himwho/jf-pimpleclock/image/ARM.png

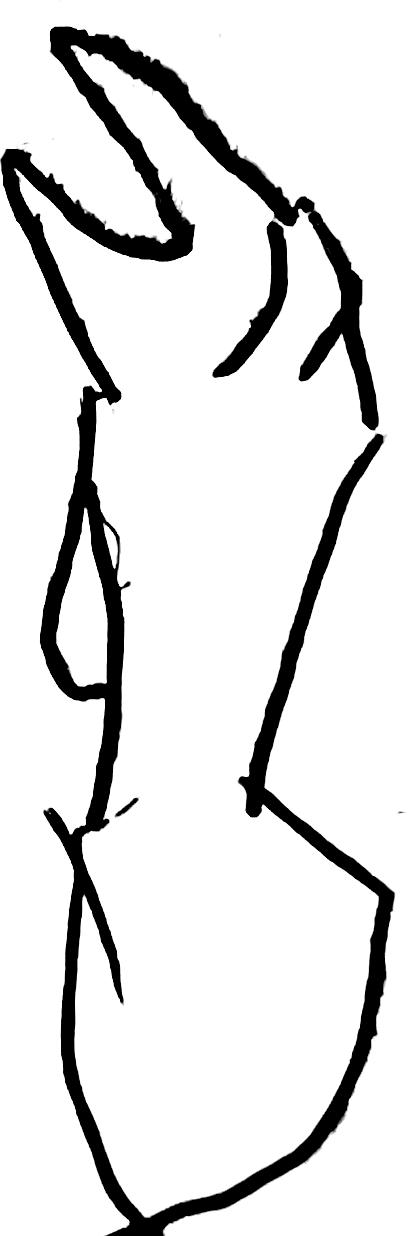
image/ARM.png
