himwho/jf-pimpleclock/image/EAR.png

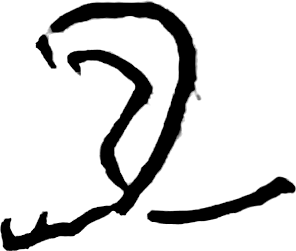
image/EAR.png
