himwho/jf-pimpleclock/image/EYE.png

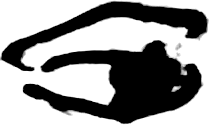
image/EYE.png
