himwho/jf-pimpleclock/image/PIMPLES.png

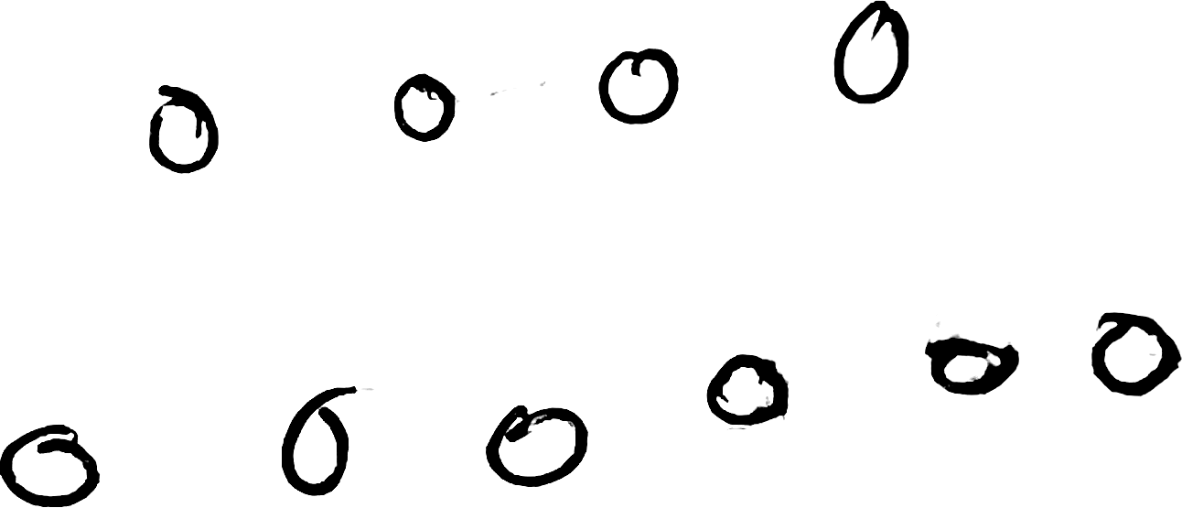
image/PIMPLES.png
