himwho/jf-pimpleclock/image/PIMPLES.dxf

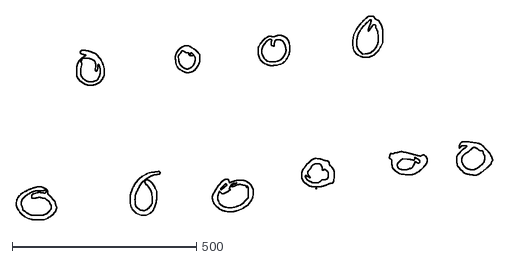
[picture p5: CAD file, 2023-01-11]
image/PIMPLES.dxf
1290.9 x 552.8
