himwho/jf-pimpleclock/parts/3362P-1-103LF.step

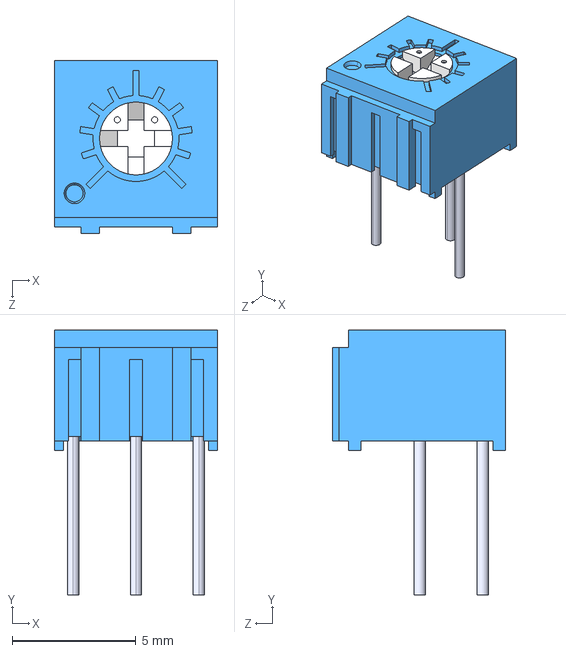
[picture p6: CAD file, 2025-08-01]
parts/3362P-1-103LF.step
6.60 x 10.7 x 6.99 mm
