himwho/jf-pimpleclock/parts/DFR0299/DFR0299.step

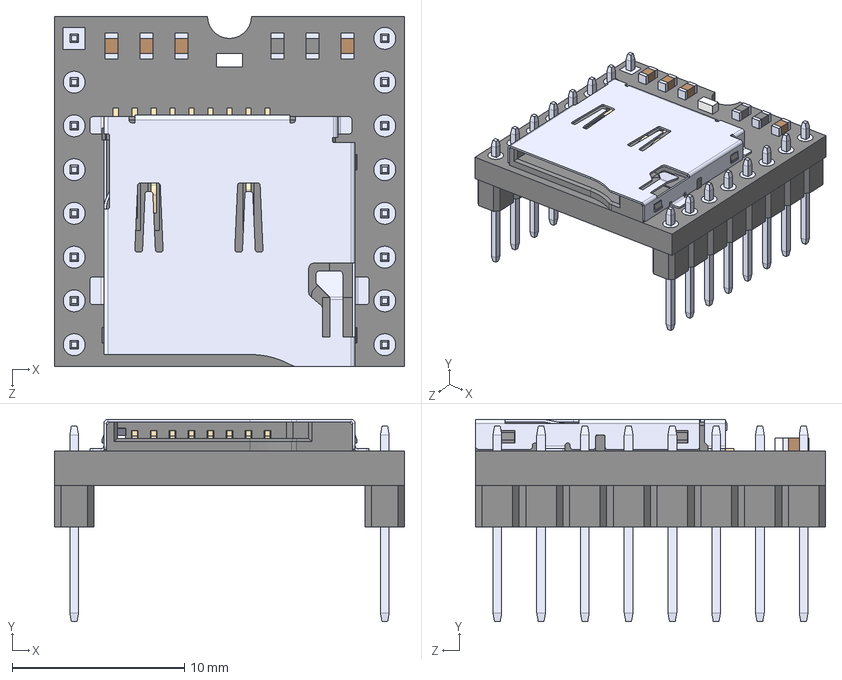
[picture p7: CAD file, 2023-01-13]
parts/DFR0299/DFR0299.step
20.3 x 11.8 x 20.3 mm
