himwho/jf-pimpleclock/image/EYE.dxf

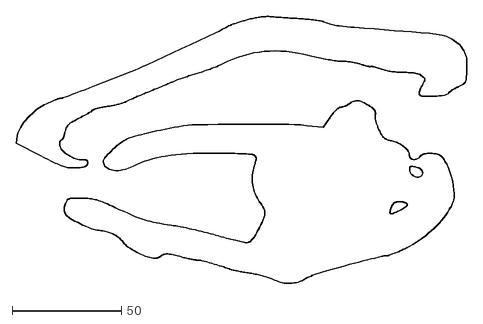
[picture p8: CAD file, 2023-01-11]
image/EYE.dxf
206.3 x 122.2
