himwho/jf-pimpleclock/image/EAR.dxf

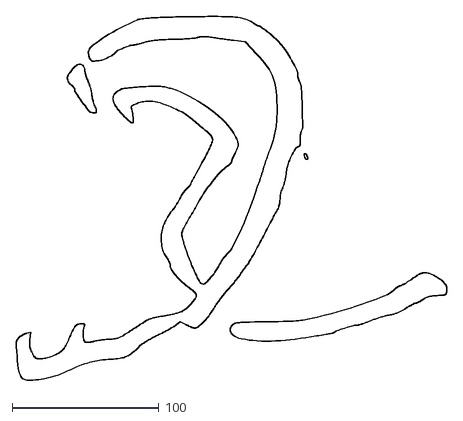
[picture p9: CAD file, 2023-01-11]
image/EAR.dxf
293.7 x 248.3
