himwho/jf-pimpleclock/image/outline_test_2.dxf

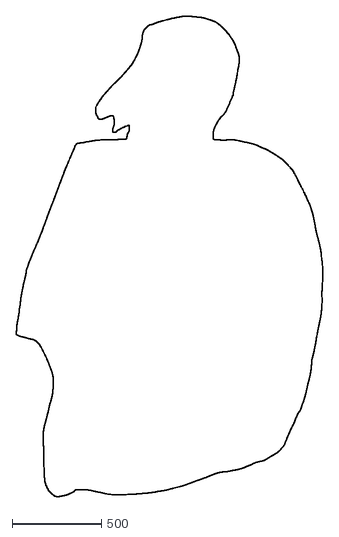
[picture p10: CAD file, 2023-01-11]
image/outline_test_2.dxf
1712.5 x 2686.9
