himwho/jf-pimpleclock/image/outline_test_3.dxf

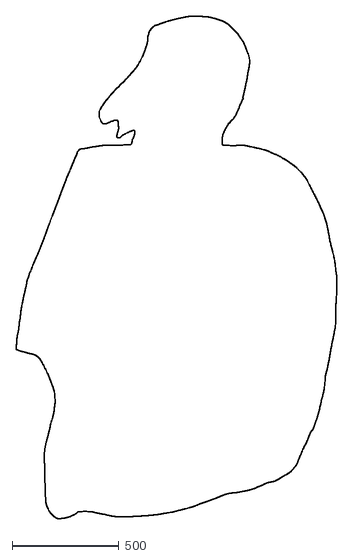
[picture p11: CAD file, 2023-01-11]
image/outline_test_3.dxf
1498.9 x 2351.6
