himwho/jf-pimpleclock/image/ARM.dxf

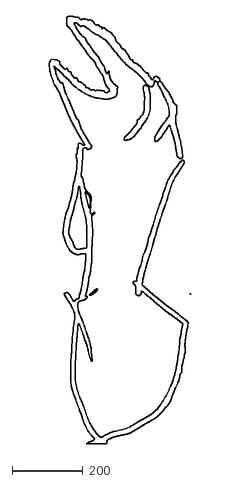
[picture p12: CAD file, 2023-01-11]
image/ARM.dxf
400.6 x 1209.0
