himwho/jf-pimpleclock/image/NECK.dxf

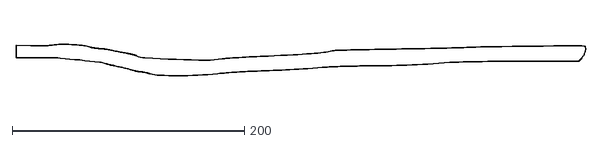
[picture p13: CAD file, 2023-01-11]
image/NECK.dxf
490.5 x 27.0
