himwho/jf-pimpleclock/image/NOSE.dxf

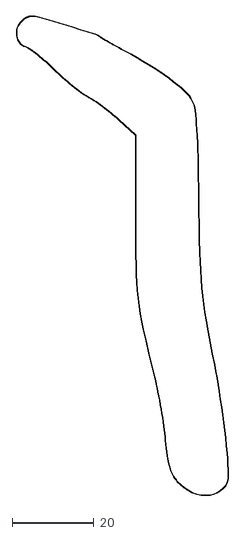
[picture p14: CAD file, 2023-01-11]
image/NOSE.dxf
52.0 x 117.6
