himwho/jf-pimpleclock/(list of files, cad)

Other CAD files:
image/outline_test.dxf
