himwho/jf-pimpleclock/image/outline_test.png

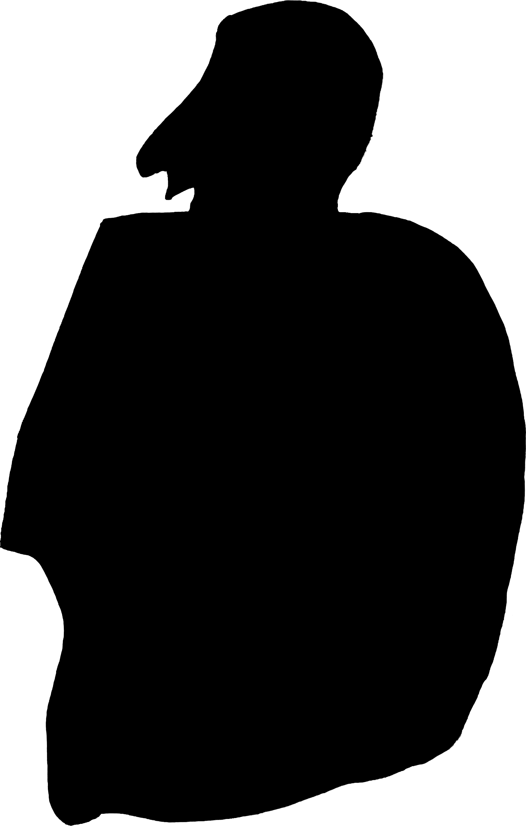
image/outline_test.png
