himwho/jf-pimpleclock/JF-Clock_template_rpi.kicad_pcb

## KiCad design JF-Clock_template_rpi.kicad_pcb (2025-08-01)

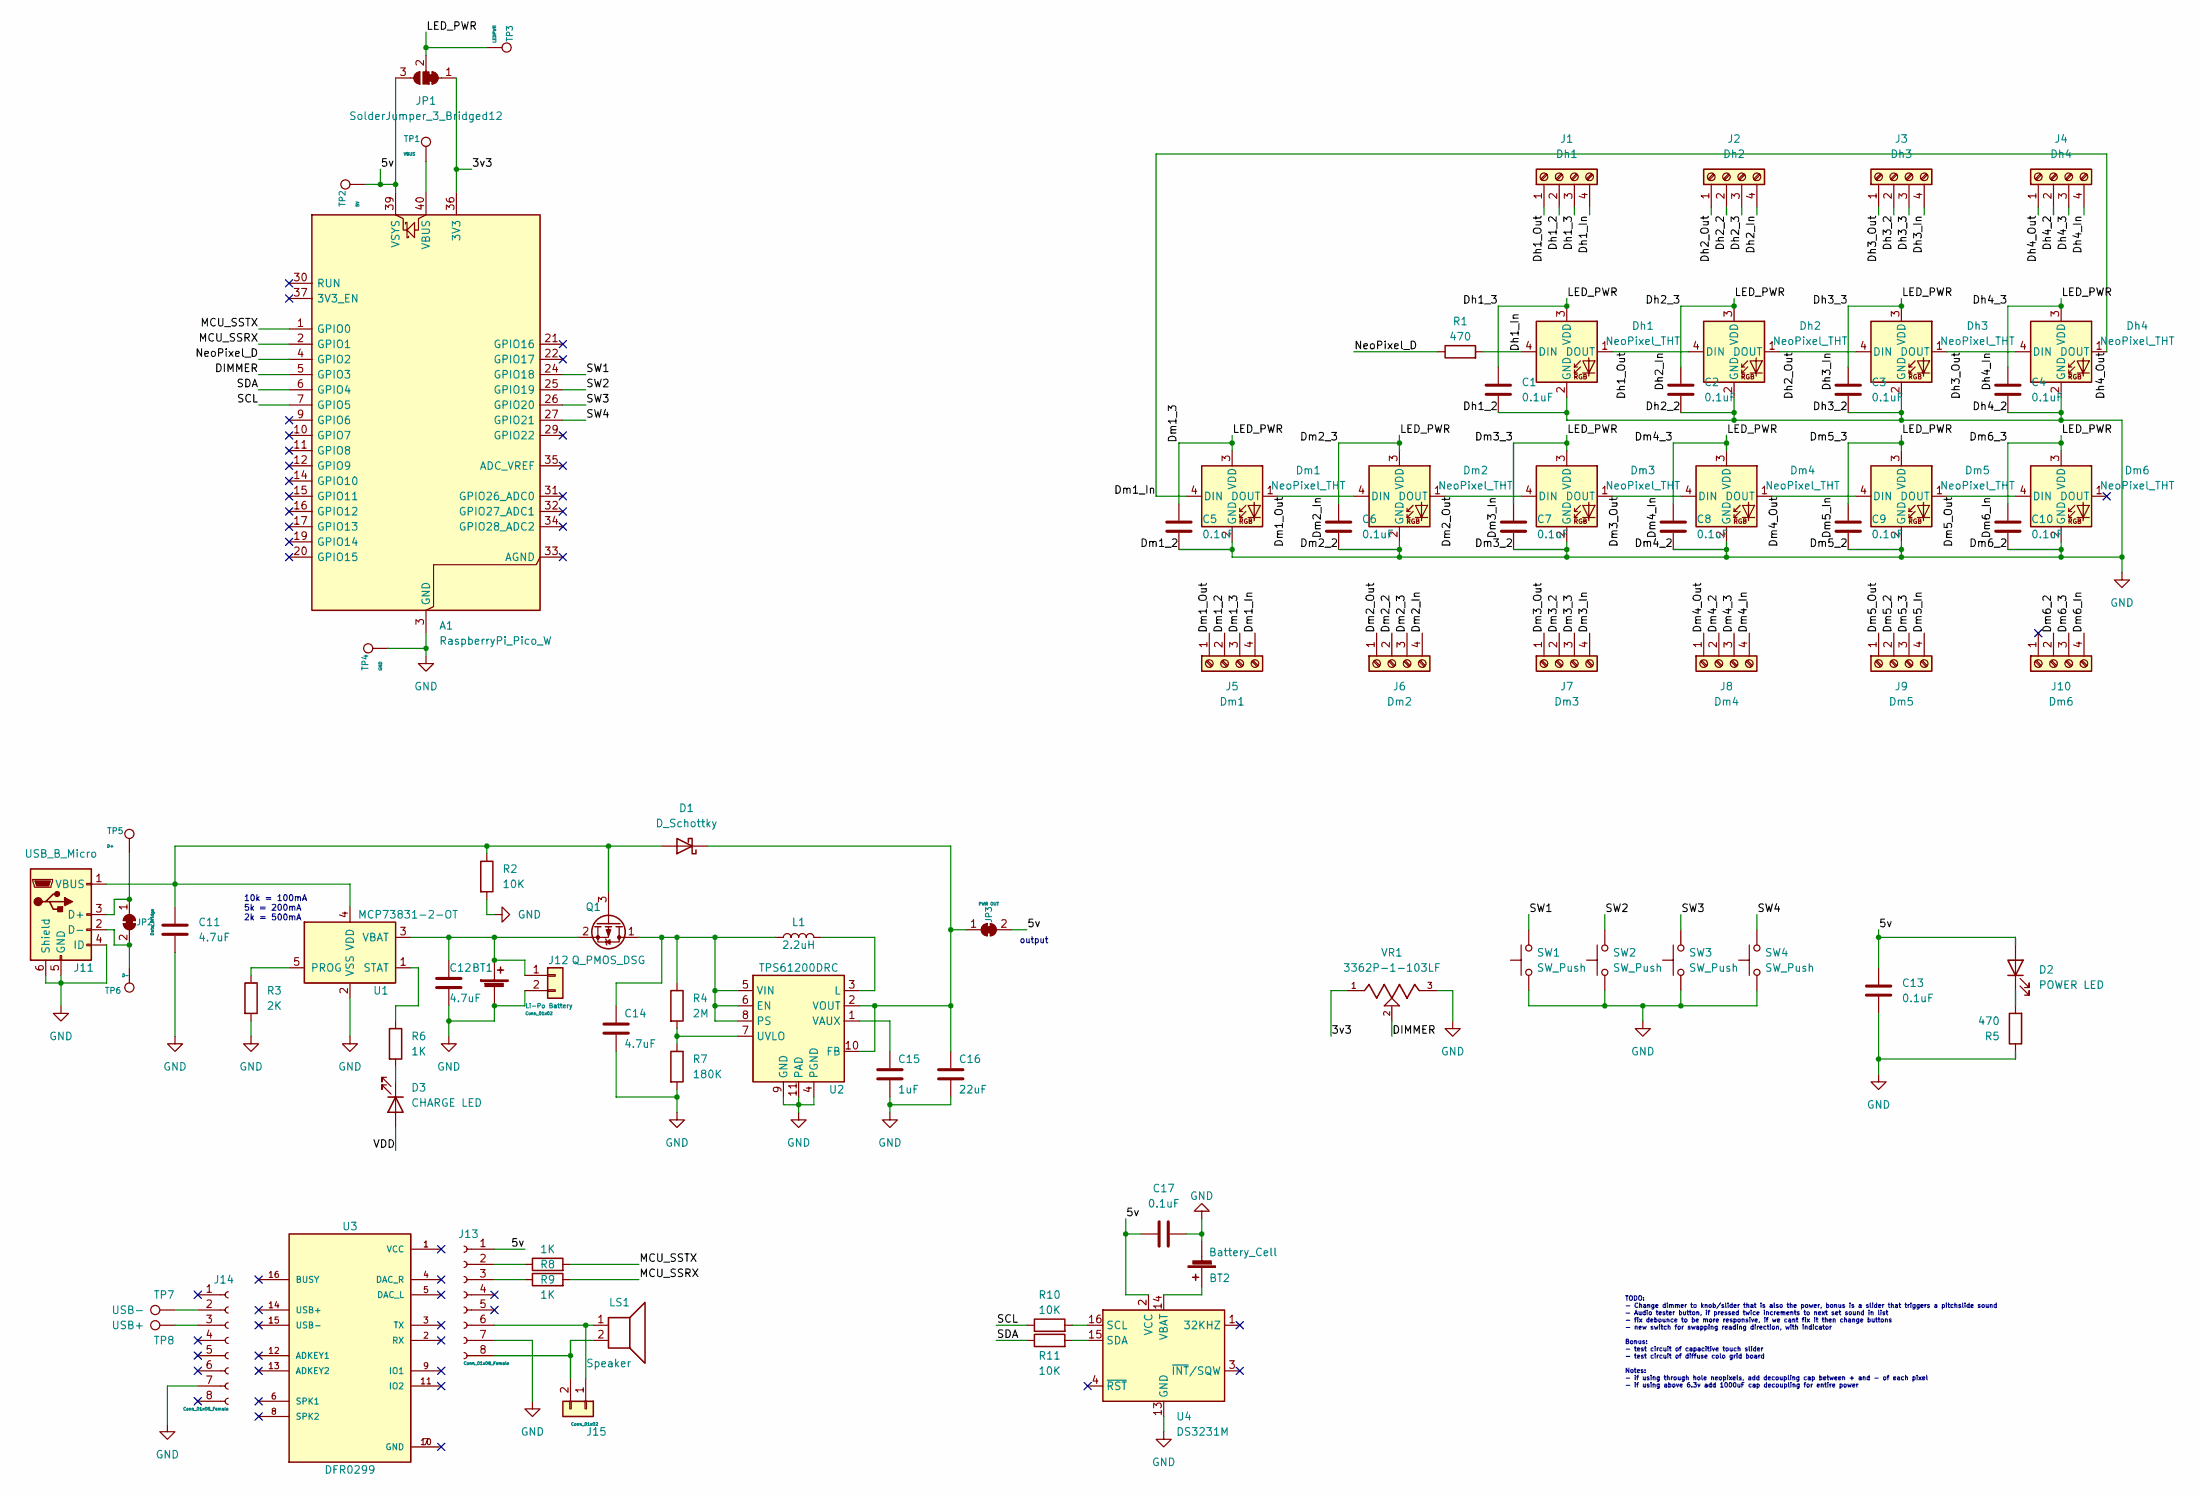
[picture p16: schematic JF-Clock_template_rpi.kicad_sch, JoeyFrank - Clock Circuit Template]

Parts:
A1: RaspberryPi_Pico_W; RaspberryPi_Pico_Common_THT
BT1: Li-Po Battery
BT2: Battery_Cell; BatteryHolder_Keystone_1060_1x2032
C1, C2, C3, C4, C5, C6, C7, C8, C9, C10, C13, C17: 0.1uF; C_0805_2012Metric
C11, C12, C14: 4.7uF; C_0805_2012Metric
C15: 1uF; C_0805_2012Metric
C16: 22uF; C_0805_2012Metric
D1: D_Schottky; D_SMA
D2: POWER LED; LED_0603_1608Metric
D3: CHARGE LED; LED_0603_1608Metric
Dh1, Dh2, Dh3, Dh4: NeoPixel_THT; LED_D5.0mm-4_RGB
Dm1, Dm2, Dm3, Dm4, Dm5, Dm6: NeoPixel_THT; LED_D5.0mm-4_RGB
J1: Dh1; TerminalBlock_4Ucon_1x04_P3.50mm_Vertical
J2: Dh2; TerminalBlock_4Ucon_1x04_P3.50mm_Vertical
J3: Dh3; TerminalBlock_4Ucon_1x04_P3.50mm_Vertical
J4: Dh4; TerminalBlock_4Ucon_1x04_P3.50mm_Vertical
J5: Dm1; TerminalBlock_4Ucon_1x04_P3.50mm_Vertical
J6: Dm2; TerminalBlock_4Ucon_1x04_P3.50mm_Vertical
J7: Dm3; TerminalBlock_4Ucon_1x04_P3.50mm_Vertical
J8: Dm4; TerminalBlock_4Ucon_1x04_P3.50mm_Vertical
J9: Dm5; TerminalBlock_4Ucon_1x04_P3.50mm_Vertical
J10: Dm6; TerminalBlock_4Ucon_1x04_P3.50mm_Vertical
J11: USB_B_Micro; USB_Micro-B_Molex-105017-0001
J12: Conn_01x02; JST_PH_S2B-PH-K_1x02_P2.00mm_Horizontal
J13, J14: Conn_01x08_Female; PinHeader_1x08_P2.54mm_Vertical
J15: Conn_01x02; TestPoint_2Pads_Pitch2.54mm_Drill0.8mm
JP1: SolderJumper_3_Bridged12; SolderJumper-3_P1.3mm_Bridged12_RoundedPad1.0x1.5mm_NumberL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
JP2: Data_Bridge; SolderJumper-2_P1.3mm_Bridged_Pad1.0x1.5mm
JP3: PWR OUT; SolderJumper-2_P1.3mm_Bridged_Pad1.0x1.5mm
L1: 2.2uH; L_0603_1608Metric
LS1: Speaker; TestPoint_Bridge_Pitch2.54mm_Drill1.0mm
Q1: Q_PMOS_DSG; SOT-23
R1, R5: 470; R_0805_2012Metric
R2, R10, R11: 10K; R_0805_2012Metric
R3: 2K; R_0805_2012Metric
R4: 2M; R_0805_2012Metric
R6, R8, R9: 1K; R_0805_2012Metric
R7: 180K; R_0805_2012Metric
SW1, SW2, SW3, SW4: SW_Push; SW_PUSH_6mm_H5mm
TP1: VBUS; TestPoint_THTPad_2.5x2.5mm_Drill1.2mm
TP2: 5V; TestPoint_THTPad_2.5x2.5mm_Drill1.2mm
TP3: LEDPWR; TestPoint_THTPad_2.5x2.5mm_Drill1.2mm
TP4: GND; TestPoint_THTPad_2.5x2.5mm_Drill1.2mm
TP5: D+; TestPoint_THTPad_2.5x2.5mm_Drill1.2mm
TP6: D-; TestPoint_THTPad_2.5x2.5mm_Drill1.2mm
TP7: USB-; TestPoint_THTPad_2.5x2.5mm_Drill1.2mm
TP8: USB+; TestPoint_THTPad_2.5x2.5mm_Drill1.2mm
U1: MCP73831-2-OT; SOT-23-5
U2: TPS61200DRC; Texas_S-PVSON-N10_ThermalVias
U3: DFR0299; DFPlayer_V2
U4: DS3231M; SOIC-16W_7.5x10.3mm_P1.27mm
VR1: 3362P-1-103LF; TRIM_3362P-1-103LF

Connections:
/3v3: A1.36 (3V3), JP1.1 (A), VR1.1
/5v: A1.39 (VSYS), C13.1, C17.2, D2.2 (A), J13.1, JP1.3 (B), JP3.2 (B), TP2.1, U4.2 (VCC)
/DIMMER: A1.5 (GPIO3), VR1.2
/Dh1_3: C1.1, C2.1, C3.1, C4.1, C5.1, C6.1, C7.1, C8.1, C9.1, C10.1, Dh1.3 (VDD), Dh2.3 (VDD), Dh3.3 (VDD), Dh4.3 (VDD), Dm1.3 (VDD), Dm2.3 (VDD), Dm3.3 (VDD), Dm4.3 (VDD), Dm5.3 (VDD), Dm6.3 (VDD), J1.3, J2.3, J3.3, J4.3, J5.3, J6.3, J7.3, J8.3, J9.3, J10.3, JP1.2 (C), TP3.1
/Dh1_In: Dh1.4 (DIN), J1.4, R1.2
/Dh1_Out: Dh1.1 (DOUT), Dh2.4 (DIN), J1.1, J2.4
/Dh2_Out: Dh2.1 (DOUT), Dh3.4 (DIN), J2.1, J3.4
/Dh3_Out: Dh3.1 (DOUT), Dh4.4 (DIN), J3.1, J4.4
/Dh4_Out: Dh4.1 (DOUT), Dm1.4 (DIN), J4.1, J5.4
/Dm1_Out: Dm1.1 (DOUT), Dm2.4 (DIN), J5.1, J6.4
/Dm2_Out: Dm2.1 (DOUT), Dm3.4 (DIN), J6.1, J7.4
/Dm3_Out: Dm3.1 (DOUT), Dm4.4 (DIN), J7.1, J8.4
/Dm4_Out: Dm4.1 (DOUT), Dm5.4 (DIN), J8.1, J9.4
/Dm5_Out: Dm5.1 (DOUT), Dm6.4 (DIN), J9.1, J10.4
/MCU_SSRX: A1.2 (GPIO1), R9.2
/MCU_SSTX: A1.1 (GPIO0), R8.2
/NeoPixel_D: A1.4 (GPIO2), R1.1
/SCL: A1.7 (GPIO5), R10.1
/SDA: A1.6 (GPIO4), R11.1
/SW1: A1.24 (GPIO18), SW1.2
/SW2: A1.25 (GPIO19), SW2.2
/SW3: A1.26 (GPIO20), SW3.2
/SW4: A1.27 (GPIO21), SW4.2
/VDD: D3.2 (A)
GND: A1.3 (GND), A1.8 (GND), A1.13 (GND), A1.18 (GND), A1.23 (GND), A1.28 (GND), A1.38 (GND), BT1.2 (-), BT2.2 (-), C1.2, C2.2, C3.2, C4.2, C5.2, C6.2, C7.2, C8.2, C9.2, C10.2, C11.2, C12.2, C13.2, C14.2, C15.2, C16.2, C17.1, Dh1.2 (GND), Dh2.2 (GND), Dh3.2 (GND), Dh4.2 (GND), Dm1.2 (GND), Dm2.2 (GND), Dm3.2 (GND), Dm4.2 (GND), Dm5.2 (GND), Dm6.2 (GND), J1.2, J2.2, J3.2, J4.2, J5.2, J6.2, J7.2, J8.2, J9.2, J10.2, J11.4 (ID), J11.5 (GND), J11.6 (Shield), J12.2, J13.7, J14.7, R2.2, R3.2, R5.1, R7.2, SW1.1, SW2.1, SW3.1, SW4.1, TP4.1, U1.2 (VSS), U2.4 (PGND), U2.9 (GND), U2.11 (PAD), U4.5 (GND), U4.6 (GND), U4.7 (GND), U4.8 (GND), U4.9 (GND), U4.10 (GND), U4.11 (GND), U4.12 (GND), U4.13 (GND), VR1.3
unnamed: A1.40 (VBUS), TP1.1
unnamed: BT2.1 (+), U4.14 (VBAT)
unnamed: C11.1, D1.2 (A), J11.1 (VBUS), Q1.3 (G), R2.1, U1.4 (VDD)
unnamed: C16.1, D1.1 (K), JP3.1 (A), U2.2 (VOUT), U2.10 (FB)
unnamed: D2.1 (K), R5.2
unnamed: D3.1 (K), R6.2
unnamed: J11.3 (D+), JP2.1 (A), TP5.1
unnamed: J11.2 (D-), JP2.2 (B), TP6.1
unnamed: BT1.1 (+), C12.1, J12.1, Q1.2 (S), U1.3 (VBAT)
unnamed: J13.2, R8.1
unnamed: J13.3, R9.1
unnamed: J13.6, J15.1, LS1.1
unnamed: J13.8, J15.2, LS1.2
unnamed: J14.2, TP7.1
unnamed: J14.3, TP8.1
unnamed: C14.1, L1.1, Q1.1 (D), R4.1, U2.5 (VIN), U2.6 (EN), U2.8 (PS)
unnamed: R3.1, U1.5 (PROG)
unnamed: R6.1, U1.1 (STAT)
unnamed: L1.2, U2.3 (L)
unnamed: R4.2, R7.1, U2.7 (UVLO)
unnamed: C15.1, U2.1 (VAUX)
unnamed: U3.7 (GND), U3.10 (GND)
unnamed: R10.2, U4.16 (SCL)
unnamed: R11.2, U4.15 (SDA)

Notes on the sheet:
10k = 100mA 5k = 200mA 2k = 500mA
TODO: - Change dimmer to knob/slider that is also the power, bonus is a slider that triggers a pitchslide sound - Audio tester button, if pressed twice increments to next set sound in list - fix debounce to be more responsive, if we cant fix it then change buttons - new switch for swapping reading 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
output

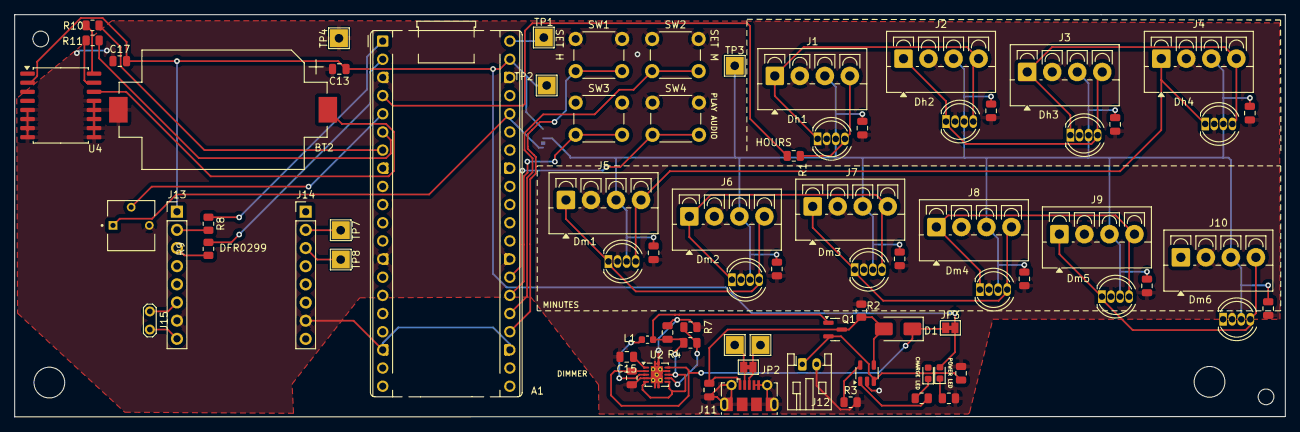
[picture p17: board JF-Clock_template_rpi.kicad_pcb from above]

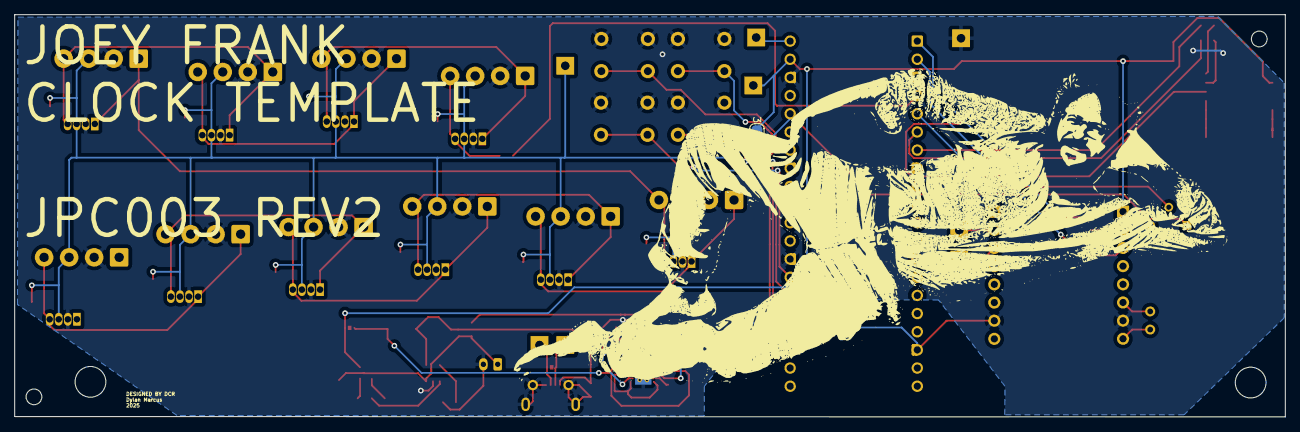
[picture p18: board JF-Clock_template_rpi.kicad_pcb from below]

Board: 2 copper layers, 177.7 x 56.2 mm, 84 parts (2 on the bottom side), 47 nets.

Other parts of the board:
DrillHole1, DrillHole2: MountingHole_2.2mm_M2
DrillHole3, DrillHole4: MountingHole_4.3mm_M4
JF: 1; ec2f3285-075e-41d4-8f47-5025fa669693
