himwho/jf-pimpleclock/JF-Clock_template.kicad_pcb

## KiCad design JF-Clock_template.kicad_pcb (2025-06-18)

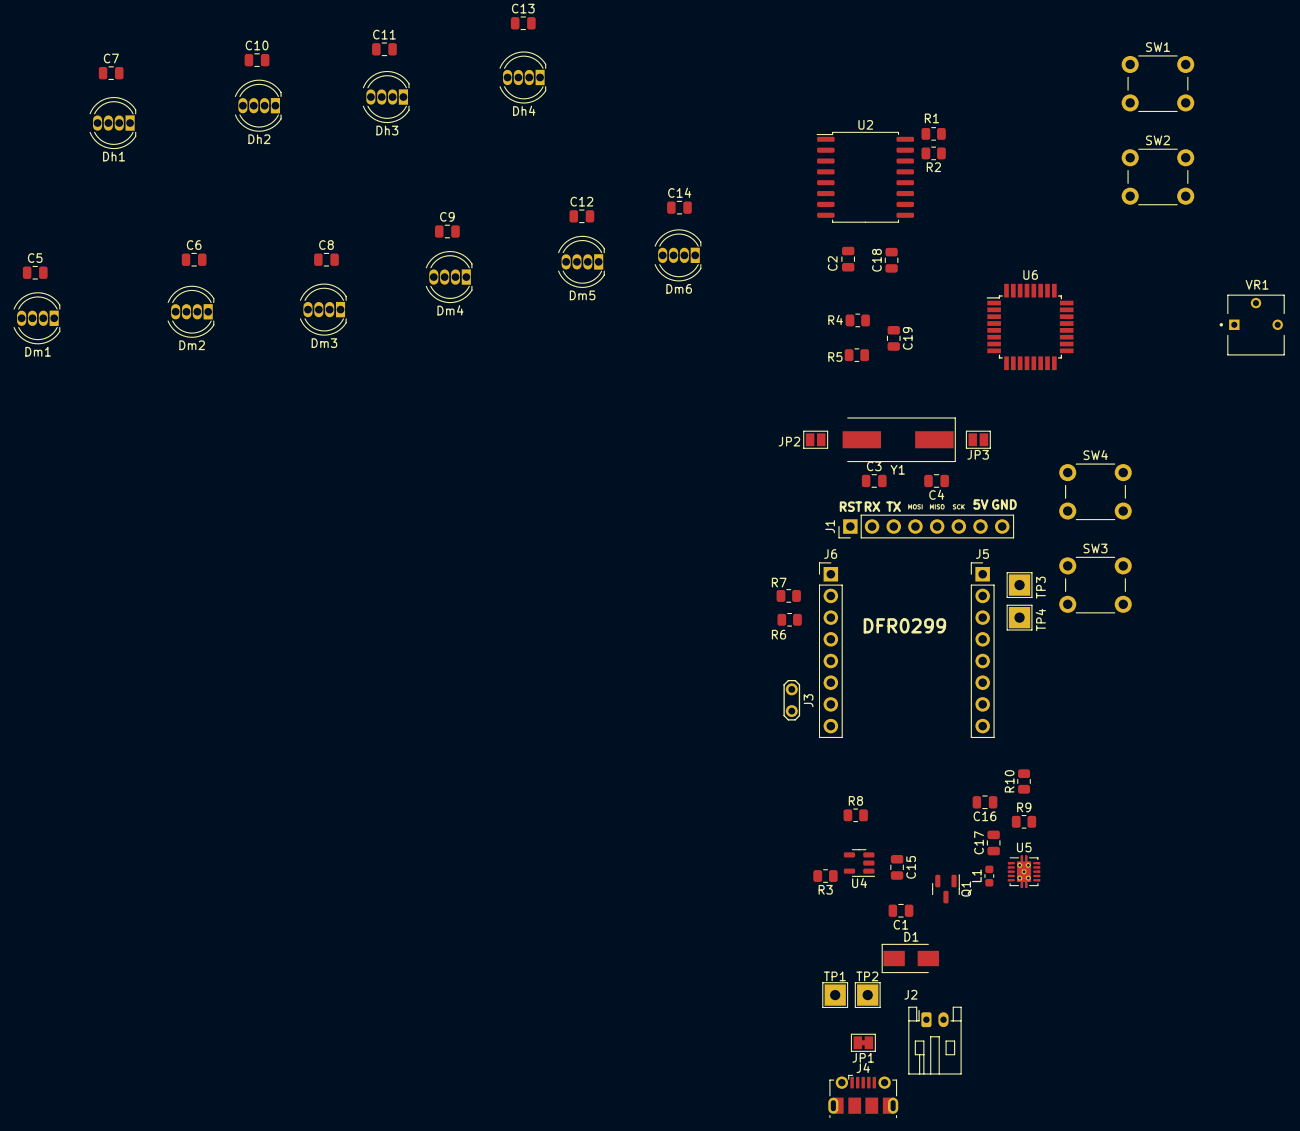
[picture p19: board JF-Clock_template.kicad_pcb from above]

Board: 2 copper layers, 66 parts (1 on the bottom side), 50 nets, no tracks yet.

Parts:
BT1: Battery_Cell; BatteryHolder_Keystone_1060_1x2032
C1, C15, C16: 4.7uF; C_0805_2012Metric
C2, C5, C6, C7, C8, C9, C10, C11, C12, C13, C14: 0.1uF; C_0805_2012Metric
C3, C4: 22pF; C_0805_2012Metric
C17: 1uF; C_0805_2012Metric
C18: 22uF; C_0805_2012Metric
C19: 100nF; C_0805_2012Metric
D1: D_Schottky; D_SMA
Dh1, Dh2, Dh3, Dh4: NeoPixel_THT; LED_D5.0mm-4_RGB
Dm1, Dm2, Dm3, Dm4, Dm5, Dm6: NeoPixel_THT; LED_D5.0mm-4_RGB
J1, J5, J6: Conn_01x08_Female; PinHeader_1x08_P2.54mm_Vertical
J2: Conn_01x02; JST_PH_S2B-PH-K_1x02_P2.00mm_Horizontal
J3: Conn_01x02; TestPoint_2Pads_Pitch2.54mm_Drill0.8mm
J4: USB_B_Micro; USB_Micro-B_Molex-105017-0001
JP1: Data_Bridge; SolderJumper-2_P1.3mm_Bridged_Pad1.0x1.5mm
JP2: XTAL_1; SolderJumper-2_P1.3mm_Open_Pad1.0x1.5mm
JP3: XTAL_2; SolderJumper-2_P1.3mm_Open_Pad1.0x1.5mm
L1: 2.2uH; L_0603_1608Metric
Q1: Q_PMOS_DSG; SOT-23
R1, R2, R4, R8: 10K; R_0805_2012Metric
R3: 2K; R_0805_2012Metric
R5: 470; R_0805_2012Metric
R6, R7: 1K; R_0805_2012Metric
R9: 2M; R_0805_2012Metric
R10: 180K; R_0805_2012Metric
SW1, SW2, SW3, SW4: SW_Push; SW_PUSH_6mm_H5mm
TP1: D+; TestPoint_THTPad_2.5x2.5mm_Drill1.2mm
TP2: D-; TestPoint_THTPad_2.5x2.5mm_Drill1.2mm
TP3: USB-; TestPoint_THTPad_2.5x2.5mm_Drill1.2mm
TP4: USB+; TestPoint_THTPad_2.5x2.5mm_Drill1.2mm
U2: DS3231M; SOIC-16W_7.5x10.3mm_P1.27mm
U4: MCP73831-2-OT; SOT-23-5
U5: TPS61200DRC; Texas_S-PVSON-N10_ThermalVias
U6: ATmega328P-A; TQFP-32_7x7mm_P0.8mm
VR1: 3362P-1-103LF; TRIM_3362P-1-103LF
Y1: 16Mhz; Crystal_SMD_HC49-SD

Connections:
/5v: C2.1, C5.1, C6.1, C7.1, C8.1, C9.1, C10.1, C11.1, C12.1, C13.1, C14.1, C18.1, C19.2, D1.1 (K), Dh1.3 (VDD), Dh2.3 (VDD), Dh3.3 (VDD), Dh4.3 (VDD), Dm1.3 (VDD), Dm2.3 (VDD), Dm3.3 (VDD), Dm4.3 (VDD), Dm5.3 (VDD), Dm6.3 (VDD), J1.7, J6.1, R4.2, U2.2 (VCC), U5.2 (VOUT), U5.10 (FB), U6.4 (VCC), U6.6 (VCC), U6.18 (AVCC), VR1.1
/DIMMER: U6.26 (PC3), VR1.2
/MCU_RX: J1.2, U6.30 (PD0)
/MCU_SSRX: R6.2, U6.9 (PD5)
/MCU_SSTX: R7.2, U6.10 (PD6)
/MCU_TX: J1.3, U6.31 (PD1)
/MISO: J1.5, U6.16 (PB4)
/MOSI: J1.4, U6.15 (PB3)
/NeoPixel_D: R5.1, U6.2 (PD4)
/RESET: J1.1, R4.1, U6.29 (~RESET/PC6)
/SCK: J1.6, U6.17 (PB5)
/SCL: R1.1, U6.28 (PC5)
/SDA: R2.1, U6.27 (PC4)
/SW1: SW1.2, U6.32 (PD2)
/SW2: SW2.2, U6.1 (PD3)
/SW3: SW3.2, U6.12 (PB0)
/SW4: SW4.2, U6.13 (PB1)
GND: BT1.2 (-), C1.2, C2.2, C3.2, C4.2, C5.2, C6.2, C7.2, C8.2, C9.2, C10.2, C11.2, C12.2, C13.2, C14.2, C15.2, C16.2, C17.2, C18.2, C19.1, Dh1.2 (GND), Dh2.2 (GND), Dh3.2 (GND), Dh4.2 (GND), Dm1.2 (GND), Dm2.2 (GND), Dm3.2 (GND), Dm4.2 (GND), Dm5.2 (GND), Dm6.2 (GND), J1.8, J2.2, J4.4 (ID), J4.5 (GND), J4.6 (Shield), J5.7, J6.7, R3.2, R8.2, R10.2, SW1.1, SW2.1, SW3.1, SW4.1, U2.5 (GND), U2.6 (GND), U2.7 (GND), U2.8 (GND), U2.9 (GND), U2.10 (GND), U2.11 (GND), U2.12 (GND), U2.13 (GND), U4.2 (VSS), U5.4 (PGND), U5.9 (GND), U5.11 (PAD), U6.3 (GND), U6.5 (GND), U6.21 (GND), VR1.3
unnamed: BT1.1 (+), U2.14 (VBAT)
unnamed: C15.1, J2.1, Q1.2 (S), U4.3 (VBAT)
unnamed: C1.1, D1.2 (A), J4.1 (VBUS), Q1.3 (G), R8.1, U4.4 (VDD)
unnamed: C3.1, JP2.2 (B), Y1.2
unnamed: C4.1, JP3.2 (B), Y1.1
unnamed: C16.1, L1.1, Q1.1 (D), R9.1, U5.5 (VIN), U5.6 (EN), U5.8 (PS)
unnamed: C17.1, U5.1 (VAUX)
unnamed: Dh1.1 (DOUT), Dh2.4 (DIN)
unnamed: Dh1.4 (DIN), R5.2
unnamed: Dh2.1 (DOUT), Dh3.4 (DIN)
unnamed: Dh3.1 (DOUT), Dh4.4 (DIN)
unnamed: Dh4.1 (DOUT), Dm1.4 (DIN)
unnamed: Dm1.1 (DOUT), Dm2.4 (DIN)
unnamed: Dm2.1 (DOUT), Dm3.4 (DIN)
unnamed: Dm3.1 (DOUT), Dm4.4 (DIN)
unnamed: Dm4.1 (DOUT), Dm5.4 (DIN)
unnamed: Dm5.1 (DOUT), Dm6.4 (DIN)
unnamed: J3.1, J6.6
unnamed: J3.2, J6.8
unnamed: J4.2 (D-), JP1.2 (B), TP2.1
unnamed: J4.3 (D+), JP1.1 (A), TP1.1
unnamed: J5.2, TP3.1
unnamed: J5.3, TP4.1
unnamed: J6.2, R7.1
unnamed: J6.3, R6.1
unnamed: JP2.1 (A), U6.7 (XTAL1/PB6)
unnamed: JP3.1 (A), U6.8 (XTAL2/PB7)
unnamed: L1.2, U5.3 (L)
unnamed: R1.2, U2.16 (SCL)
unnamed: R2.2, U2.15 (SDA)
unnamed: R3.1, U4.5 (PROG)
unnamed: R9.2, R10.1, U5.7 (UVLO)
