himwho/jf-pimpleclock/(commit log)

2023-01-05 initial commit of revision 1 schem
    [JF-PimpleClock.kicad_pcb, JF-PimpleClock.kicad_sch, JF-PimpleClock_r1.kicad_sch]
2023-01-07 init for new voltage regulator and lipo management
    [JF-PimpleClock.kicad_sch]
2023-01-11 init for pcb layout with test outline silk and shape
    [ARM.dxf, EAR.dxf, EYE.dxf, JF-PimpleClock.kicad_pcb, JF-PimpleClock.kicad_sch, NECK.dxf, NOSE.dxf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]
2023-01-13 started first pcb test layout and some part assignment to jcl
    [DFR0299.step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]
2023-01-13 update pcb layout, swapped a few parts to make them easier for assembly
    [JF-PimpleClock.kicad_pcb, JF-PimpleClock.kicad_sch]
2023-01-14 revisions for pcb layout, new cheaper parts selected, this went out into a test production
    [JF-PimpleClock-CuBottom.gbr, JF-PimpleClock-CuTop.gbr, JF-PimpleClock-EdgeCuts.gbr, JF-PimpleClock-MaskBottom.gbr, JF-PimpleClock-MaskTop.gbr, JF-PimpleClock-NPTH.drl, JF-PimpleClock-PTH.drl, JF-PimpleClock-PasteBottom.gbr]
2023-02-01 small circuit tweak for fixing missing vcc/avcc ref for bootloader
    [JF-PimpleClock.kicad_pcb, JF-PimpleClock.kicad_sch]
2023-03-17 revision 2, changed some parts for making it easier to manufacture, fixed the issue with the wrong atmega footprint, added more test points
    [JF-PimpleClock-CuBottom.gbr, JF-PimpleClock-CuTop.gbr, JF-PimpleClock-EdgeCuts.gbr, JF-PimpleClock-MaskBottom.gbr, JF-PimpleClock-MaskTop.gbr, JF-PimpleClock-NPTH.drl, JF-PimpleClock-PTH.drl, JF-PimpleClock-PasteBottom.gbr]
2023-05-07 fixed 1pm bug, fixed position of M and H buttons
    [JoeyRTCPimplePinkBinaryClock_r2.ino]
2023-05-07 fixed hour and minute led display based on new circuit
    [JoeyRTCPimplePinkBinaryClock_r2.ino]
2023-05-07 fix color and added dimmer
    [JoeyRTCPimplePinkBinaryClock_r2.ino]
2025-06-18 init for python version on pico W
    [JF-Clock_template.kicad_pcb, JF-Clock_template.kicad_sch, JF-Clock_template_r2.kicad_sch, JF-Clock_template_rpi.kicad_pcb, JF-Clock_template_rpi.kicad_sch, JF-PimpleClock_r3.kicad_sch]
2025-06-18 update from projects
    [3362P-1-103LF.step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]
2025-08-01 update for project
    [3362P-1-103LF.step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]
